wyolum/Chronogram2/README.md

Chronogram2
===========

Word clock that tells time to the minute
