wyolum/Chronogram2/KiCAD/README.txt

The board design files can be found here: https://github.com/wyolum/ClockTHREEjr
