wyolum/Chronogram2/fabricate/Chronogram_v1_BoM_seeed_RetailClock v2.xlsx

Electronic Engineering BOM List
Product Name： ClockTHREEjr – Retail , complete assembled unit | Chronogram2 - Assembled Retail Unit
Version：V1.0
Issue Date：19/10/2012 | 3rd March 2014
Item No. (序号) | Reference Des (上件位置) | Qty (用量) | Catalog (分类） | Part_Description (规格描述) | Part_Value （元件值） | Part_Package （元件封装） | Manufacturers Name (使用厂牌名称) | Manufacturers Part No. (使用厂牌型号) | Distributors Name （供应商名称） | Distributors Part No. (供貨商型号) | Unit Price （单价） | Price Break To Use （价格分段的购买量） | Notes/Remark （备注）
Example（填写范例）
1 |  | 2 | OTHER | ClockTHREEjr kit from Seeed BOM |  |  | Seeed Studio Parts kit and PCB from supplied BOM
2 |  | 33 | OTHER | Vertical Baffle (0.06" Acrylic Black) |  | 0.06” Thick Acrylic, Black | Laser Cut | Baffles_cg2_v0.1alpha.pdf
3 |  | 9 | OTHER | Horizontal Baffle (0.06" Acrylic Black) |  | 0.06” Thick Acrylic, Black | Laser Cut | Baffles_cg2_v0.1alpha.pdf
4 |  | 8 | OTHER | Round Localizing Washers (0.06" Acrylic Black) |  | 0.06” Thick Acrylic, Black | Laser Cut | Baffles_cg2_v0.1alpha.pdf
5 |  | 1 | OTHER | Back Plate (.25" Lightly Smoked Acrylic) |  | 0.25” Thick, Acrylic, Black | Laser Cut + Engrave | CHRONOGRAM Backplate cg2_v0.1alpha
6 |  | 1 | OTHER | Black Front Plate (0.25" Acrylic Black) |  | 0.25” Thick, Acrylic | Laser Cut + Engrave | english2_v1_UbuntuMono-BoldItalic_lower_39_cg2_v0.1alpha.pdf
7 |  | 4 | OTHER | M3 Stand Offs 20mm, - Part No : 94868A176 (we prefer ROUND, not HEX) |  | Standoff, M3x20mm, Round, SS | McMaster | 94868A176 |  |  |  |  | http://www.mcmaster.com/#standard-threaded-standoffs/=jrofov
8 |  | 8 | OTHER | M3 16mm low head hex screws - Part No : 92855A316 |  | Screw, M3x16mm, Low Head Socket, SS | McMaster | 92855A316 |  |  |  |  | http://www.mcmaster.com/#metric-socket-head-cap-screws/=jroaog
9 |  | 8 | OTHER | M3 12mm low head hex screws - Part No : 92855A313 |  | Screw, M3x12mm, Low Head Socket, SS | McMaster | 92855A313 |  |  |  |  | http://www.mcmaster.com/#metric-socket-head-cap-screws/=jroaog
10 |  | 16 | OTHER | M3 hex nut - Part No : 91828A211 |  | Nut, M3, Hex, SS | McMaster | 91828A211 |  |  |  |  | http://www.mcmaster.com/#metric-hex-nuts/=jroctc
11 |  | 1 | OTHER | Power Supply (usb adapter) |  |  | Seeed Studio (please TEST)
12 |  | 1 | OTHER | USB Cable, Type B to Mini (Black 6') |  |  | Seeed Studio
13 |  | 1 | OTHER | 4 position male header - right angle |  |  |  |  |  |  |  |  | i.e. digikey part no 609-3312-ND
14 |  | 1 | OTHER | 4 position female socket - right angle |  |  |  |  |  |  |  |  | i.e. digikey part no. S5440-ND
1. Recommended Distributor: Digi-Key, Mouser, Avnet Express, Farnell.
2. Catalog: Capacitor,Resister,Diode,Connector,Transistor,IC,PROTECTOR CATEGORY,OTHER
3. Required Fields: Item No, Reference Des, Qty, Catalog, Part_Value, Part Package
Optional Fields: Part_Description, Manufacturers Name, Manufacturers Part No, Distributors Name, Distributors Part No, Unit Cost, Price break to use, Notes/Remark
