wyolum/Chronogram2/fabricate/Baffles_cg2_v0.1alpha.pdf

Localizer, 8 per CHRONOGRAM2

H BAFFLE, 10 per CHRONOGRAM2

V BAFFLE, 34 per CHRONOGRAM2
