wyolum/Chronogram2/fabricate/english2_v1_UbuntuMono-BoldItalic_lower_39_cg2_v0.1alpha.pdf

FPID: 39

UBUNTUMONO-BOLDITALIC

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

UbuntuMono-BoldItalic
