wyolum/Chronogram2/fabricate/Langs/German2_v1440.csv

WyoLum Text Format
version=1440 |  | 0 | 1 | 2 | 3 | 4 | 5 | 6 | 7 | 8 | 9 | 10 | 11 | 12 | 13 | 14 | 15 | 16 | 17 | 18 | 19 | 20 | 21 | 22 | 23 | 24 | 25 | 26 | 27 | 28 | 29 | 30 | 31
Custom with two kits | 0 | e | s | b | i | s | t | s | i | n | d | k | e | i | n | e | - | z | w | e | i | - | d | r | e | i | - | t | v | i | e | r | - | 0
n_row = 8 | 1 | f | ü | n | f | - | s | e | c | h | s | - | s | i | e | b | e | n | - | a | c | h | t | - | n | e | u | n | - | z | e | h | n | 1
n_col = 32 | 2 | e | l | f | e | z | w | ö | l | f | i | g | u | n | d | - | i | n | z | w | a | n | z | i | g | s | m | i | n | u | t | e | n | 2
data_start=26 | 3 | v | i | e | r | t | e | l | e | v | o | r | n | a | c | h | u | h | a | l | b | h | e | i | n | s | - | n | z | w | e | i | - | 3
 | 4 | d | r | e | i | - | o | v | i | e | r | - | u | f | ü | n | f | - | ö | s | e | c | h | s | - | ä | s | i | e | b | e | n | - | 4
 | 5 | a | c | h | t | - | ü | n | e | u | n | - | q | z | e | h | n | v | e | l | f | e | z | w | ö | l | f | e | l | u | n | d | - | 5
 | 6 | z | w | a | n | z | i | g | k | h | u | h | r | s | m | o | r | g | e | n | s | t | r | v | o | r | m | i | t | t | a | g | s | 6
 | 7 | n | a | c | h | m | i | t | t | a | g | s | m | a | b | e | n | d | s | b | ö | m | i | t | t | e | r | n | a | c | h | t | s | 7
 |  | 0 | 1 | 2 | 3 | 4 | 5 | 6 | 7 | 8 | 9 | 10 | 11 | 12 | 13 | 14 | 15 | 16 | 17 | 18 | 19 | 20 | 21 | 22 | 23 | 24 | 25 | 26 | 27 | 28 | 29 | 30 | 31
author | Dirk Siegel
email | dirk@siegel.me
licence | http://creativecommons.org/licenses/by/3.0/
description | Two Panel Clock | German with 1440 individaully defined sentences!
n_word=71 | es | ist | sind | ein | eine | - | zwei | - | drei | - | vier | - | fünf | - | sechs | sech | - | sieben | sieb | - | acht | - | neun | - | zehn | elf | zwölf | und | - | zwanzig | minute | minuten | viertel | vor | nach | halb | ein | eins | - | zwei | - | drei | - | vier | - | fünf | - | sechs | sech | - | sieben | sieb | - | acht | - | neun | - | zehn | elf
start_row | 0 | 0 | 0 | 0 | 0 | 0 | 0 | 0 | 0 | 0 | 0 | 0 | 1 | 1 | 1 | 1 | 1 | 1 | 1 | 1 | 1 | 1 | 1 | 1 | 1 | 2 | 2 | 2 | 2 | 2 | 2 | 2 | 3 | 3 | 3 | 3 | 3 | 3 | 3 | 3 | 3 | 4 | 4 | 4 | 4 | 4 | 4 | 4 | 4 | 4 | 4 | 4 | 4 | 5 | 5 | 5 | 5 | 5 | 5
start_col | 0 | 3 | 6 | 11 | 11 | 15 | 16 | 20 | 21 | 25 | 27 | 31 | 0 | 4 | 5 | 5 | 10 | 11 | 11 | 17 | 18 | 22 | 23 | 27 | 28 | 0 | 4 | 11 | 14 | 17 | 25 | 25 | 0 | 8 | 11 | 16 | 21 | 21 | 25 | 27 | 31 | 0 | 4 | 6 | 10 | 12 | 16 | 18 | 18 | 23 | 25 | 25 | 31 | 0 | 4 | 6 | 10 | 12 | 17
length | 2 | 3 | 4 | 3 | 4 | 1 | 4 | 1 | 4 | 1 | 4 | 1 | 4 | 1 | 5 | 4 | 1 | 6 | 4 | 1 | 4 | 1 | 4 | 1 | 4 | 3 | 5 | 3 | 1 | 7 | 6 | 7 | 7 | 3 | 4 | 4 | 3 | 4 | 1 | 4 | 1 | 4 | 1 | 4 | 1 | 4 | 1 | 5 | 4 | 1 | 6 | 4 | 1 | 4 | 1 | 4 | 1 | 4 | 3
00:00 | es | ist
00:01 | es | ist |  |  | eine |  |  |  |  |  |  |  |  |  |  |  |  |  |  |  |  |  |  |  |  |  |  |  |  |  | minute |  |  |  | nach
00:02 | es |  | sind |  |  |  | zwei |  |  |  |  |  |  |  |  |  |  |  |  |  |  |  |  |  |  |  |  |  |  |  |  | minuten |  |  | nach
00:03 | es |  | sind |  |  |  |  |  | drei |  |  |  |  |  |  |  |  |  |  |  |  |  |  |  |  |  |  |  |  |  |  | minuten |  |  | nach
00:04 | es |  | sind |  |  |  |  |  |  |  | vier |  |  |  |  |  |  |  |  |  |  |  |  |  |  |  |  |  |  |  |  | minuten |  |  | nach
00:05 | es |  | sind |  |  |  |  |  |  |  |  |  | fünf |  |  |  |  |  |  |  |  |  |  |  |  |  |  |  |  |  |  | minuten |  |  | nach
00:06 | es |  | sind |  |  |  |  |  |  |  |  |  |  |  | sechs |  |  |  |  |  |  |  |  |  |  |  |  |  |  |  |  | minuten |  |  | nach
00:07 | es |  | sind |  |  |  |  |  |  |  |  |  |  |  |  |  |  | sieben |  |  |  |  |  |  |  |  |  |  |  |  |  | minuten |  |  | nach
00:08 | es |  | sind |  |  |  |  |  |  |  |  |  |  |  |  |  |  |  |  |  | acht |  |  |  |  |  |  |  |  |  |  | minuten |  |  | nach
00:09 | es |  | sind |  |  |  |  |  |  |  |  |  |  |  |  |  |  |  |  |  |  |  | neun |  |  |  |  |  |  |  |  | minuten |  |  | nach
00:10 | es |  | sind |  |  |  |  |  |  |  |  |  |  |  |  |  |  |  |  |  |  |  |  |  | zehn |  |  |  |  |  |  | minuten |  |  | nach
00:11 | es |  | sind |  |  |  |  |  |  |  |  |  |  |  |  |  |  |  |  |  |  |  |  |  |  | elf |  |  |  |  |  | minuten |  |  | nach
00:12 | es |  | sind |  |  |  |  |  |  |  |  |  |  |  |  |  |  |  |  |  |  |  |  |  |  |  | zwölf |  |  |  |  | minuten |  |  | nach
00:13 | es |  | sind |  |  |  |  |  | drei | - |  |  |  |  |  |  |  |  |  |  |  |  |  |  | zehn |  |  |  |  |  |  | minuten |  |  | nach
00:14 | es |  | sind |  |  |  |  |  |  |  | vier | - |  |  |  |  |  |  |  |  |  |  |  |  | zehn |  |  |  |  |  |  | minuten |  |  | nach
00:15 | es | ist |  |  |  |  |  |  |  |  |  |  |  |  |  |  |  |  |  |  |  |  |  |  |  |  |  |  |  |  |  |  | viertel |  | nach
00:16 | es |  | sind |  |  |  |  |  |  |  |  |  |  |  |  | sech | - |  |  |  |  |  |  |  | zehn |  |  |  |  |  |  | minuten |  |  | nach
00:17 | es |  | sind |  |  |  |  |  |  |  |  |  |  |  |  |  |  |  | sieb | - |  |  |  |  | zehn |  |  |  |  |  |  | minuten |  |  | nach
00:18 | es |  | sind |  |  |  |  |  |  |  |  |  |  |  |  |  |  |  |  |  | acht | - |  |  | zehn |  |  |  |  |  |  | minuten |  |  | nach
00:19 | es |  | sind |  |  |  |  |  |  |  |  |  |  |  |  |  |  |  |  |  |  |  | neun | - | zehn |  |  |  |  |  |  | minuten |  |  | nach
00:20 | es |  | sind |  |  |  |  |  |  |  |  |  |  |  |  |  |  |  |  |  |  |  |  |  |  |  |  |  |  | zwanzig |  | minuten |  |  | nach
00:21 | es |  | sind | ein |  | - |  |  |  |  |  |  |  |  |  |  |  |  |  |  |  |  |  |  |  |  |  | und | - | zwanzig |  | minuten |  |  | nach
00:22 | es |  | sind |  |  |  | zwei | - |  |  |  |  |  |  |  |  |  |  |  |  |  |  |  |  |  |  |  | und | - | zwanzig |  | minuten |  |  | nach
00:23 | es |  | sind |  |  |  |  |  | drei | - |  |  |  |  |  |  |  |  |  |  |  |  |  |  |  |  |  | und | - | zwanzig |  | minuten |  |  | nach
00:24 | es |  | sind |  |  |  |  |  |  |  | vier | - |  |  |  |  |  |  |  |  |  |  |  |  |  |  |  | und | - | zwanzig |  | minuten |  |  | nach
00:25 | es |  | sind |  |  |  |  |  |  |  |  |  | fünf |  |  |  |  |  |  |  |  |  |  |  |  |  |  |  |  |  |  | minuten |  | vor |  | halb |  | eins
00:26 | es |  | sind |  |  |  |  |  |  |  | vier |  |  |  |  |  |  |  |  |  |  |  |  |  |  |  |  |  |  |  |  | minuten |  | vor |  | halb |  | eins
00:27 | es |  | sind |  |  |  |  |  | drei |  |  |  |  |  |  |  |  |  |  |  |  |  |  |  |  |  |  |  |  |  |  | minuten |  | vor |  | halb |  | eins
00:28 | es |  | sind |  |  |  | zwei |  |  |  |  |  |  |  |  |  |  |  |  |  |  |  |  |  |  |  |  |  |  |  |  | minuten |  | vor |  | halb |  | eins
00:29 | es | ist |  |  | eine |  |  |  |  |  |  |  |  |  |  |  |  |  |  |  |  |  |  |  |  |  |  |  |  |  |  | minuten |  | vor |  | halb |  | eins
00:30 | es | ist |  |  |  |  |  |  |  |  |  |  |  |  |  |  |  |  |  |  |  |  |  |  |  |  |  |  |  |  |  |  |  |  |  | halb |  | eins
00:31 | es | ist |  |  | eine |  |  |  |  |  |  |  |  |  |  |  |  |  |  |  |  |  |  |  |  |  |  |  |  |  | minute |  |  |  | nach | halb |  | eins
00:32 | es |  | sind |  |  |  | zwei |  |  |  |  |  |  |  |  |  |  |  |  |  |  |  |  |  |  |  |  |  |  |  |  | minuten |  |  | nach | halb |  | eins
00:33 | es |  | sind |  |  |  |  |  | drei |  |  |  |  |  |  |  |  |  |  |  |  |  |  |  |  |  |  |  |  |  |  | minuten |  |  | nach | halb |  | eins
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
11:03 | es |  | sind |  |  |  |  |  | drei |  |  |  |  |  |  |  |  |  |  |  |  |  |  |  |  |  |  |  |  |  |  | minuten |  |  | nach |  |  |  |  |  |  |  |  |  |  |  |  |  |  |  |  |  |  |  |  |  |  |  | elf
11:04 | es |  | sind |  |  |  |  |  |  |  | vier |  |  |  |  |  |  |  |  |  |  |  |  |  |  |  |  |  |  |  |  | minuten |  |  | nach |  |  |  |  |  |  |  |  |  |  |  |  |  |  |  |  |  |  |  |  |  |  |  | elf
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
