wyolum/Chronogram2/fabricate/Backplate_cg2_v0.1alpha.pdf

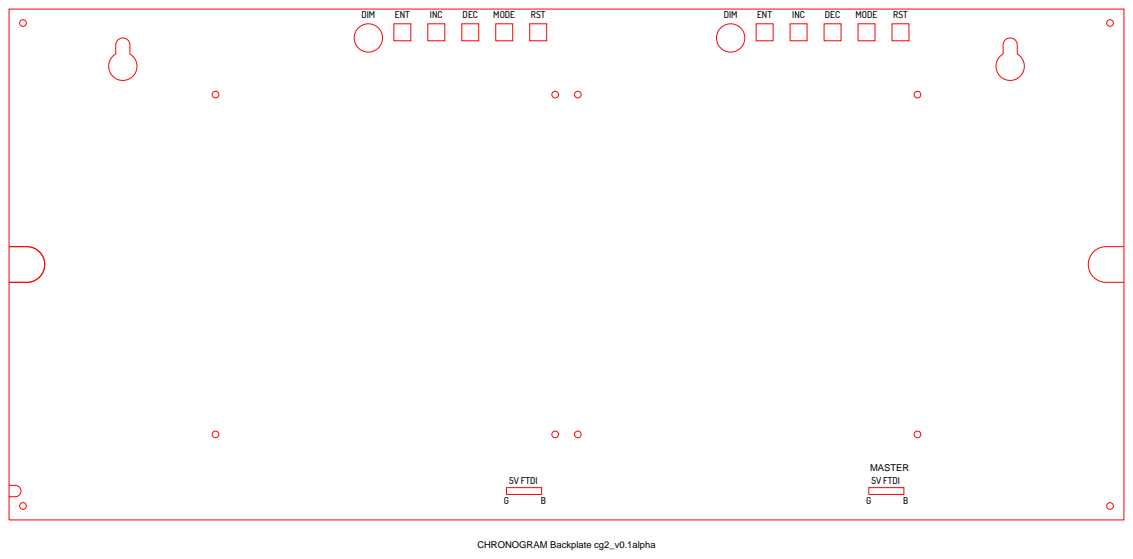
[picture p13: page 1]
CHRONOGRAM Backplate cg2_v0.1alpha; DIM; ENT; INC; DEC; MODE; RST; 5V FTDI; MASTER
