wyolum/Chronogram2/(commit log)

2014-03-08 breaking off from code.google repo
    [Chronogram_v1_BoM_seeed_RetailClock v2.xlsx]
2014-03-08 changed qty of baffles. n + 1 is for kits, n is for clocks
    [Chronogram_v1_BoM_seeed_RetailClock v2.xlsx]
2015-01-10 added python files
    [German2_v1440.csv]
